csondurr/PASSBRIDGE/results/reports/PASSBRIDGE_DIGITAL_FINAL.html

# PASSBRIDGE — Dijital Simülasyon Sonuçları

Durum: END_TO_END_SIMULATED_WITH_NUMERICAL_CAVEATS

Gerçek CST native FEM-RF: 150/150; MATLAB OFDM: 13 koşul

## Yapısal FEM mesh kontrolü

Wind_m_s | Mesh | MaxDisp_mm | MaxMises_MPa | MeshMinQuality | PreviousToCurrent_DispChangePct | PreviousToCurrent_StressChangePct
15 | 7 | 0.038032506 | 5.247483364 | 0.00001 | nan | nan
15 | 6 | 0.050418816 | 7.120265029 | 0.00329 | 24.56684 | 26.30213
15 | 5 | 0.053928798 | 6.935151066 | 0.00041 | 6.50855 | 2.66921
15 | 4 | 0.153042762 | 9.720235737 | 0.00449 | 64.76227 | 28.65244
25 | 7 | 0.105645850 | 14.576343862 | 0.00001 | nan | nan
25 | 6 | 0.140052266 | 19.778513885 | 0.00329 | 24.56684 | 26.30213
25 | 5 | 0.149802218 | 19.264308493 | 0.00041 | 6.50855 | 2.66921
25 | 4 | 0.425118782 | 27.000654762 | 0.00449 | 64.76227 | 28.65244
35 | 7 | 0.207065869 | 28.569635623 | 0.00001 | nan | nan
35 | 6 | 0.274502441 | 38.765887209 | 0.00329 | 24.56684 | 26.30212
35 | 5 | 0.293612347 | 37.758044680 | 0.00041 | 6.50855 | 2.66921
35 | 4 | 0.833232819 | 52.921283354 | 0.00449 | 64.76227 | 28.65244

## FEM→CST RCS ve bağlantı

Wind_m_s | Pol | N_cases | Nominal_Pr_dBm | Worst_Pr_dBm | Worst_AX_deg | Worst_AY_deg | Worst_SNR_dB
15 | TE | 25 | -74.8904183 | -75.8834231 | -0.2 | 0.2 | 18.106277
15 | TM | 25 | -74.9058516 | -75.897457 | -0.2 | -0.2 | 18.0922431
25 | TE | 25 | -74.8923712 | -75.8838523 | -0.2 | 0.2 | 18.1058478
25 | TM | 25 | -74.9055319 | -75.898279 | -0.2 | -0.2 | 18.0914211
35 | TE | 25 | -74.8946478 | -75.8858271 | -0.2 | 0.2 | 18.103873
35 | TM | 25 | -74.9470267 | -75.9011103 | -0.2 | -0.2 | 18.0885897

## MATLAB OFDM

Wind_m_s | Pol | Scenario | SNR_dB | BER | PER | Net_Mbps
15 | TE | ALIGNED | 19.0992818 | 0 | 0 | 26
15 | TE | WORST_TILT | 18.106277 | 0 | 0 | 26
15 | TM | ALIGNED | 19.0838485 | 0 | 0 | 26
15 | TM | WORST_TILT | 18.0922431 | 0 | 0 | 26
25 | TE | ALIGNED | 19.0973289 | 0 | 0 | 26
25 | TE | WORST_TILT | 18.1058478 | 0 | 0 | 26
25 | TM | ALIGNED | 19.0841682 | 0 | 0 | 26
25 | TM | WORST_TILT | 18.0914211 | 0 | 0 | 26
35 | TE | ALIGNED | 19.0950523 | 0 | 0 | 26
35 | TE | WORST_TILT | 18.103873 | 0 | 0 | 26
35 | TM | ALIGNED | 19.0426733 | 0 | 0 | 26
35 | TM | WORST_TILT | 18.0885897 | 0 | 0 | 26
0 | NA | NO_REFLECTOR_BLOCKED_LOS | NaN | 0.498554258241758 | 1 | 0





## Belirlenmiş model sınırları

- PASSBRIDGE G1 / numerical digital-twin evidence only
- CST model uses two finite-conductivity DX51D+Z275 sheets; COMSOL structural steel law is provisional.
- FEM front-surface u,v,w sampled and IDW-interpolated into closed finite-thickness RF solids.
- Wind is uniform pressure from a simplified force coefficient, not a code-prescribed site load.
- Finite-height / 2D beam support and true welded/bolted joint stiffness are not independently certified.
- Only 5.5 GHz field data drive the flat AWGN channel; not 802.11 MAC or measured throughput.
- No-reflector is modeled with blocked direct path; alternate multipath not simulated.
- Fullwave IE, actual site measurements, material test reports, and production certification are OUTSIDE this digital acceptance stage.

## Mesh yakınsama kriteri

- W15: displacement 64.76%, stress 28.65%, not converged
- W25: displacement 64.76%, stress 28.65%, not converged
- W35: displacement 64.76%, stress 28.65%, not converged
