csondurr/PASSBRIDGE/results/communication/MATLAB_OFDM_RESULTS.csv

Wind_m_s | Pol | Scenario | AX_deg | AY_deg | Pr_dBm | SNR_dB | BER | PER | Net_Mbps | Packets | Source
15 | TE | ALIGNED | 0 | 0 | -74.8904183 | 19.0992818 | 0 | 0 | 26 | 200 | CST_FEM_RCS_PLUS_SIMULATED_FLAT_AWGN
15 | TE | WORST_TILT | -0.2 | 0.2 | -75.8834231 | 18.106277 | 0 | 0 | 26 | 200 | CST_FEM_RCS_PLUS_SIMULATED_FLAT_AWGN
15 | TM | ALIGNED | 0 | 0 | -74.9058516 | 19.0838485 | 0 | 0 | 26 | 200 | CST_FEM_RCS_PLUS_SIMULATED_FLAT_AWGN
15 | TM | WORST_TILT | -0.2 | -0.2 | -75.897457 | 18.0922431 | 0 | 0 | 26 | 200 | CST_FEM_RCS_PLUS_SIMULATED_FLAT_AWGN
25 | TE | ALIGNED | 0 | 0 | -74.8923712 | 19.0973289 | 0 | 0 | 26 | 200 | CST_FEM_RCS_PLUS_SIMULATED_FLAT_AWGN
25 | TE | WORST_TILT | -0.2 | 0.2 | -75.8838523 | 18.1058478 | 0 | 0 | 26 | 200 | CST_FEM_RCS_PLUS_SIMULATED_FLAT_AWGN
25 | TM | ALIGNED | 0 | 0 | -74.9055319 | 19.0841682 | 0 | 0 | 26 | 200 | CST_FEM_RCS_PLUS_SIMULATED_FLAT_AWGN
25 | TM | WORST_TILT | -0.2 | -0.2 | -75.898279 | 18.0914211 | 0 | 0 | 26 | 200 | CST_FEM_RCS_PLUS_SIMULATED_FLAT_AWGN
35 | TE | ALIGNED | 0 | 0 | -74.8946478 | 19.0950523 | 0 | 0 | 26 | 200 | CST_FEM_RCS_PLUS_SIMULATED_FLAT_AWGN
35 | TE | WORST_TILT | -0.2 | 0.2 | -75.8858271 | 18.103873 | 0 | 0 | 26 | 200 | CST_FEM_RCS_PLUS_SIMULATED_FLAT_AWGN
35 | TM | ALIGNED | 0 | 0 | -74.9470267 | 19.0426733 | 0 | 0 | 26 | 200 | CST_FEM_RCS_PLUS_SIMULATED_FLAT_AWGN
35 | TM | WORST_TILT | -0.2 | -0.2 | -75.9011103 | 18.0885897 | 0 | 0 | 26 | 200 | CST_FEM_RCS_PLUS_SIMULATED_FLAT_AWGN
0 | NA | NO_REFLECTOR_BLOCKED_LOS | 0 | 0 | NaN | NaN | 0.498554258241758 | 1 | 0 | 200 | ASSUMED_BLOCKED_PATH_NO_SCATTERER
