csondurr/PASSBRIDGE/results/fem/FEM_RESULTS.csv

mesh_size | windspeed_m_s | pressure_Pa | max_displacement_mm | max_mises_MPa | solver_status | project_file
7 | 15 | 248.062500000 | 0.038032506 | 5.247483364 | SOLVED_METRICS_EXTRACTED | G1_MESH7_W15.mph
7 | 25 | 689.062500000 | 0.105645850 | 14.576343862 | SOLVED_METRICS_EXTRACTED | G1_MESH7_W25.mph
7 | 35 | 1350.562500000 | 0.207065869 | 28.569635623 | SOLVED_METRICS_EXTRACTED | G1_MESH7_W35.mph
6 | 15 | 248.062500000 | 0.050418816 | 7.120265029 | SOLVED_METRICS_EXTRACTED | G1_MESH6_W15.mph
6 | 25 | 689.062500000 | 0.140052266 | 19.778513885 | SOLVED_METRICS_EXTRACTED | G1_MESH6_W25.mph
6 | 35 | 1350.562500000 | 0.274502441 | 38.765887209 | SOLVED_METRICS_EXTRACTED | G1_MESH6_W35.mph
5 | 15 | 248.062500000 | 0.053928798 | 6.935151066 | SOLVED_METRICS_EXTRACTED | G1_MESH5_W15.mph
5 | 25 | 689.062500000 | 0.149802218 | 19.264308493 | SOLVED_METRICS_EXTRACTED | G1_MESH5_W25.mph
5 | 35 | 1350.562500000 | 0.293612347 | 37.758044680 | SOLVED_METRICS_EXTRACTED | G1_MESH5_W35.mph
