csondurr/PASSBRIDGE/results/fem/MESH_QA.csv

Wind_m_s | Mesh | MaxDisp_mm | MaxMises_MPa | MeshMinQuality | PreviousToCurrent_DispChangePct | PreviousToCurrent_StressChangePct
15 | 7 | 0.038032506 | 5.247483364 | 1.077e-05 | nan | nan
15 | 6 | 0.050418816 | 7.120265029 | 0.003286 | 24.566840284389063 | 26.302134223548997
15 | 5 | 0.053928798 | 6.935151066 | 0.0004136 | 6.508548549515236 | 2.669213132321394
15 | 4 | 0.153042762 | 9.720235737 | 0.004494 | 64.76226820841092 | 28.652439574058853
25 | 7 | 0.105645850 | 14.576343862 | 1.077e-05 | nan | nan
25 | 6 | 0.140052266 | 19.778513885 | 0.003286 | 24.5668399253176 | 26.302127921478057
25 | 5 | 0.149802218 | 19.264308493 | 0.0004136 | 6.508549826678787 | 2.6692128201063756
25 | 4 | 0.425118782 | 27.000654762 | 0.004494 | 64.76226778425423 | 28.65243949523745
35 | 7 | 0.207065869 | 28.569635623 | 1.077e-05 | nan | nan
35 | 6 | 0.274502441 | 38.765887209 | 0.003286 | 24.56683873350328 | 26.30212364553547
35 | 5 | 0.293612347 | 37.758044680 | 0.0004136 | 6.508549860132417 | 2.669212713585891
35 | 4 | 0.833232819 | 52.921283354 | 0.004494 | 64.76226808344187 | 28.652439459130967
