csondurr/PASSBRIDGE/results/rf/CST_RUNS.csv

Wind_m_s | AX_deg | AY_deg | Status | NativeTE | NativeTM | Message
15 | 0 | 0 | SOLVED | data/cst_native/FEM_W15_X0_Y0/TE.txt | data/cst_native/FEM_W15_X0_Y0/TM.txt | CST native scattered field verified
15 | 0 | -0.1 | SOLVED | data/cst_native/FEM_W15_X0_Ym0p1/TE.txt | data/cst_native/FEM_W15_X0_Ym0p1/TM.txt | CST native scattered field verified
15 | 0 | 0.1 | SOLVED | data/cst_native/FEM_W15_X0_Y0p1/TE.txt | data/cst_native/FEM_W15_X0_Y0p1/TM.txt | CST native scattered field verified
15 | 0 | -0.2 | SOLVED | data/cst_native/FEM_W15_X0_Ym0p2/TE.txt | data/cst_native/FEM_W15_X0_Ym0p2/TM.txt | CST native scattered field verified
15 | 0 | 0.2 | SOLVED | data/cst_native/FEM_W15_X0_Y0p2/TE.txt | data/cst_native/FEM_W15_X0_Y0p2/TM.txt | CST native scattered field verified
15 | -0.1 | 0 | SOLVED | data/cst_native/FEM_W15_Xm0p1_Y0/TE.txt | data/cst_native/FEM_W15_Xm0p1_Y0/TM.txt | CST native scattered field verified
15 | -0.1 | -0.1 | SOLVED | data/cst_native/FEM_W15_Xm0p1_Ym0p1/TE.txt | data/cst_native/FEM_W15_Xm0p1_Ym0p1/TM.txt | CST native scattered field verified
15 | -0.1 | 0.1 | SOLVED | data/cst_native/FEM_W15_Xm0p1_Y0p1/TE.txt | data/cst_native/FEM_W15_Xm0p1_Y0p1/TM.txt | CST native scattered field verified
15 | -0.1 | -0.2 | SOLVED | data/cst_native/FEM_W15_Xm0p1_Ym0p2/TE.txt | data/cst_native/FEM_W15_Xm0p1_Ym0p2/TM.txt | CST native scattered field verified
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
35 | 0.2 | 0.2 | SOLVED | data/cst_native/FEM_W35_X0p2_Y0p2/TE.txt | data/cst_native/FEM_W35_X0p2_Y0p2/TM.txt | CST native scattered field verified
