csondurr/PASSBRIDGE/results/rf/LINK_CASES.csv

Case | Wind_m_s | AX_deg | AY_deg | Pol | RCS_dBsm | Pr_dBm | Noise_dBm | SNR_dB | ThetaCutPeak_deg | ThetaCutPeak_dBsm | DataClass | SourcePath
FEM_W15_X0_Y0 | 15 | 0.0 | 0.0 | TE | 45.3155176 | -74.8904183 | -93.9897 | 19.0992818 | 45.0 | 45.3155176 | NATIVE_CST_SBR_FEM_DEFORMATION | data/cst_native/FEM_W15_X0_Y0/TE.txt
FEM_W15_X0_Y0 | 15 | 0.0 | 0.0 | TM | 45.3000843 | -74.9058516 | -93.9897 | 19.0838485 | 45.0 | 45.3000843 | NATIVE_CST_SBR_FEM_DEFORMATION | data/cst_native/FEM_W15_X0_Y0/TM.txt
FEM_W15_X0_Y0p1 | 15 | 0.0 | 0.1 | TE | 45.181943 | -75.0239928 | -93.9897 | 18.9657072 | 45.2 | 45.2978412 | NATIVE_CST_SBR_FEM_DEFORMATION | data/cst_native/FEM_W15_X0_Y0p1/TE.txt
FEM_W15_X0_Y0p1 | 15 | 0.0 | 0.1 | TM | 45.1875502 | -75.0183856 | -93.9897 | 18.9713144 | 45.2 | 45.2824039 | NATIVE_CST_SBR_FEM_DEFORMATION | data/cst_native/FEM_W15_X0_Y0p1/TM.txt
FEM_W15_X0_Y0p2 | 15 | 0.0 | 0.2 | TE | 44.8157788 | -75.390157 | -93.9897 | 18.599543 | 45.4 | 45.2805711 | NATIVE_CST_SBR_FEM_DEFORMATION | data/cst_native/FEM_W15_X0_Y0p2/TE.txt
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
