csondurr/PASSBRIDGE/(commit log)

2026-10-27 Initial PASSBRIDGE numerical feasibility study: models, native fields, FEM and OFDM results
    [CST_RUNS.csv, FEM_RESULTS.csv, LINK_CASES.csv, MATLAB_OFDM_RESULTS.csv, MESH_QA.csv, REFINED_FEM_RESULTS.csv, SHA256_MANIFEST.csv, WORST_CASES.csv]
2026-10-27 docs: comprehensive PASSBRIDGE technical README with equations, simulation evidence and traceability
